sooft1k/Drohne/hardware/fc/docs/fc_3d_oben.png

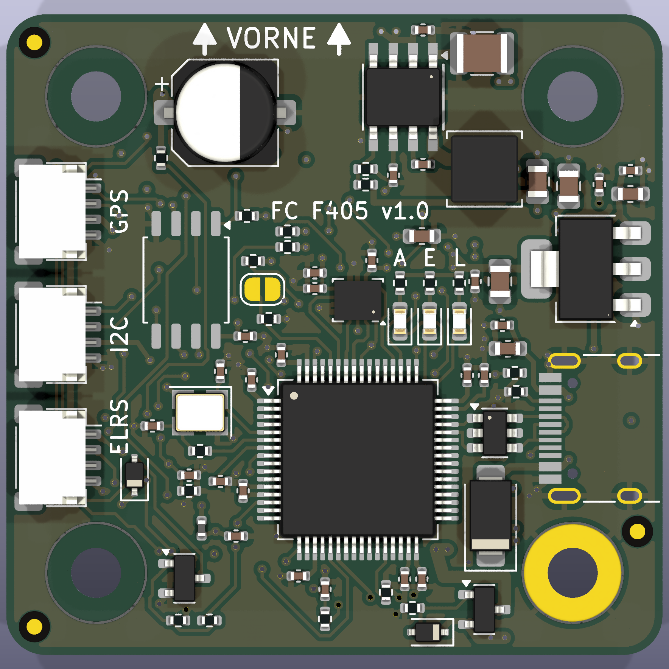
hardware/fc/docs/fc_3d_oben.png
