sooft1k/Drohne/hardware/fc/docs/fc_3d_unten.png

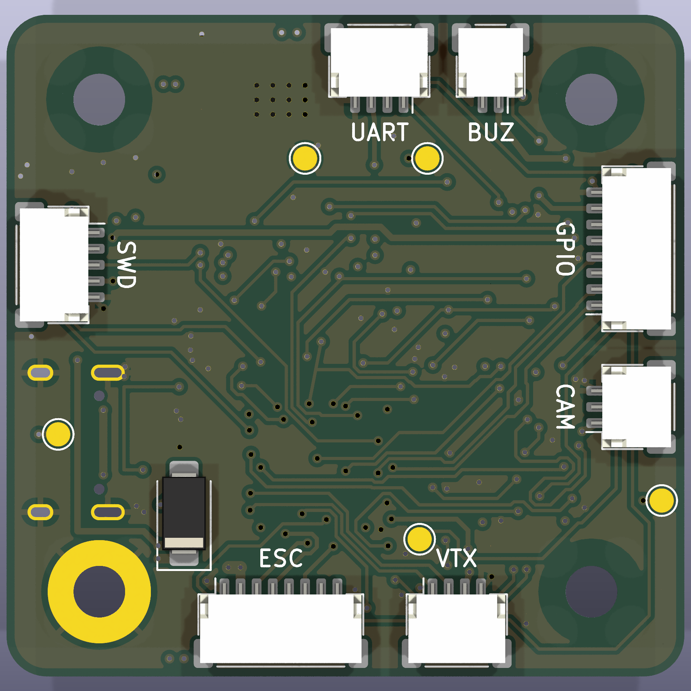
hardware/fc/docs/fc_3d_unten.png
