sooft1k/Drohne/hardware/fc/docs/fc_bot.png

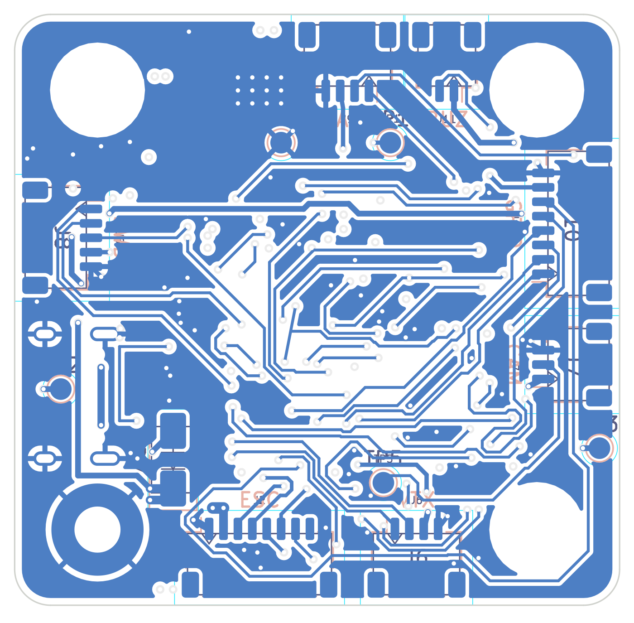
hardware/fc/docs/fc_bot.png
