sooft1k/Drohne/hardware/fc/docs/fc_in1.png

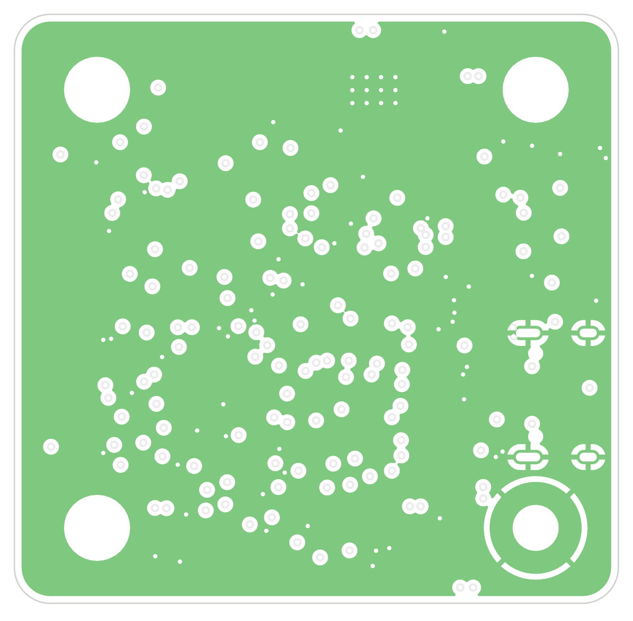
hardware/fc/docs/fc_in1.png
