sooft1k/Drohne/hardware/fc/docs/fc_in2.png

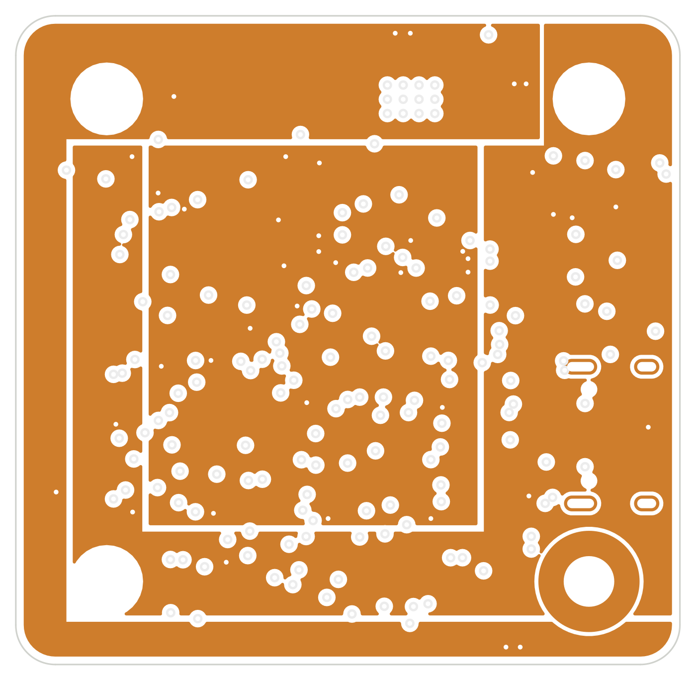
hardware/fc/docs/fc_in2.png
