sooft1k/Drohne/Pinlayout.jpeg

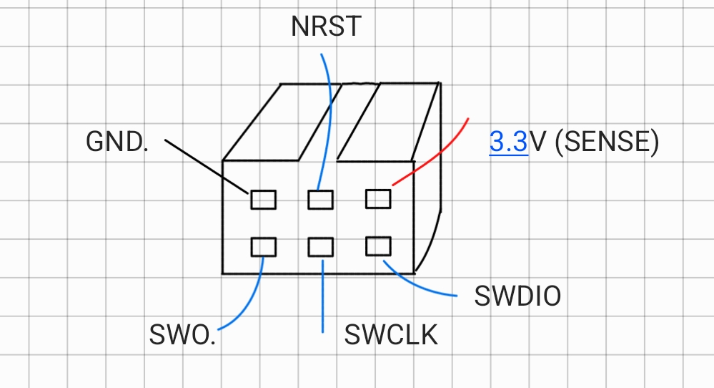
Pinlayout.jpeg
