sooft1k/Drohne/hardware/fc/fertigung/jlcpcb_bom.csv

Comment | Designator | Footprint | LCSC Part #
100 nF 50 V X7R 0402 | C1,C2,C3,C4,C5,C7,C11,C14,C15,C16,C18,C20,C23,C24,C28,C30,C32,C34 | C_0402_1005Metric | C307331
10 uF 25 V X5R 0603 | C6,C29,C33 | C_0603_1608Metric | C96446
1 uF 25 V X5R 0402 | C8,C25 | C_0402_1005Metric | C52923
2,2 uF 6,3 V X5R 0402 | C9,C10,C17 | C_0402_1005Metric | C12530
18 pF 50 V C0G 0402 | C12,C13 | C_0402_1005Metric | C1549
47 uF 35 V Elko 6,3x5,4, 850 mOhm @100 kHz, 140 mA @120 Hz | C21 | CP_Elec_6.3x5.4 | C48970990
10 uF 50 V X7R 1210 | C22 | C_1210_3225Metric | C17498688
22 uF 25 V X5R 0805 | C26,C27,C31 | C_0805_2012Metric | C45783
Zener 15 V SOD-323 | D1 | D_SOD-323 | C19077448
Schottky 40 V 1 A SMA | D2,D7 | D_SMA | C2480
LED rot 0603 | D3 | LED_0603_1608Metric | C2286
LED gelb 0603 (AlGaInP) | D4 | LED_0603_1608Metric | C72038
LED gruen 0603 (InGaN, Uf ca. 2,7 V) | D5 | LED_0603_1608Metric | C72043
Schaltdiode SOD-323 | D6 | D_SOD-323 | C2128
Ferrit 600 Ohm@100 MHz 0402, 0,23 Ohm | FB1 | L_0402_1005Metric | C7509833
USB-C-Buchse 16 Pin | J1 | USB_C_Receptacle_HRO_TYPE-C-31-M-12_Kante | C165948
JST-SH-Buchse 8-polig seitlich SMD | J2,J10 | JST_SH_SM08B-SRSS-TB_1x08-1MP_P1.00mm_Horizontal | C7430450
JST-SH-Buchse 4-polig seitlich SMD | J3,J4,J5,J6,J9 | JST_SH_SM04B-SRSS-TB_1x04-1MP_P1.00mm_Horizontal | C7430446
JST-SH-Buchse 3-polig seitlich SMD | J7 | JST_SH_SM03B-SRSS-TB_1x03-1MP_P1.00mm_Horizontal | C7430445
JST-SH-Buchse 5-polig seitlich SMD | J8 | JST_SH_SM05B-SRSS-TB_1x05-1MP_P1.00mm_Horizontal | C7430447
JST-SH-Buchse 2-polig seitlich SMD | J11 | JST_SH_SM02B-SRSS-TB_1x02-1MP_P1.00mm_Horizontal | C7430444
3,3 uH 34 mOhm 4,8/6,6 A, XAL/XGL-40xx-Landemuster | L1 | L_Coilcraft_XAL4040-XXX | C6937839
P-MOSFET -40 V SOT-23 | Q1 | SOT-23 | C146287
N-MOSFET 30 V 5,7 A SOT-23, V_GS(th) max. 1,45 V | Q2 | SOT-23 | C20917
10 kOhm 1 % 0402 | R1,R2,R5,R7,R8,R18 | R_0402_1005Metric | C25744
0 Ohm 0402 | R3 | R_0402_1005Metric | C17168
100 kOhm 1 % 0402 | R4,R9 | R_0402_1005Metric | C25741
1 kOhm 1 % 0402 | R6,R14,R15,R17 | R_0402_1005Metric | C11702
33 kOhm 1 % 0402 | R10 | R_0402_1005Metric | C25779
8,2 kOhm 1 % 0402 | R11 | R_0402_1005Metric | C25924
5,1 kOhm 1 % 0402 | R12,R13,R19,R20 | R_0402_1005Metric | C25905
470 Ohm 1 % 0402 | R16 | R_0402_1005Metric | C25117
Mikrocontroller LQFP-64 | U1 | LQFP-64_10x10mm_P0.5mm | C15742
IMU LGA-14 | U2 | LGA-14_3x2.5mm_P0.5mm_LayoutBorder3x4y | C1850418
SPI-Flash 128 Mbit SOIC-8 208 mil | U3 | SOIC-8_5.23x5.23mm_P1.27mm | C97521
Schaltregler 3 A HSOP-8 | U4 | Texas_HSOP-8-1EP_3.9x4.9mm_P1.27mm_ThermalVias_TopOnly | C544370
LDO 3,3 V SOT-223 | U5 | SOT-223-3_TabPin2 | C6186
USB-ESD-Schutz SOT-23-6 | U6 | SOT-23-6 | C7519
Quarz 8 MHz 12 pF +-10 ppm 3225-4P | Y1 | Crystal_SMD_3225-4Pin_3.2x2.5mm | C20617566
