sooft1k/Drohne/Frame/frame_assembly.step

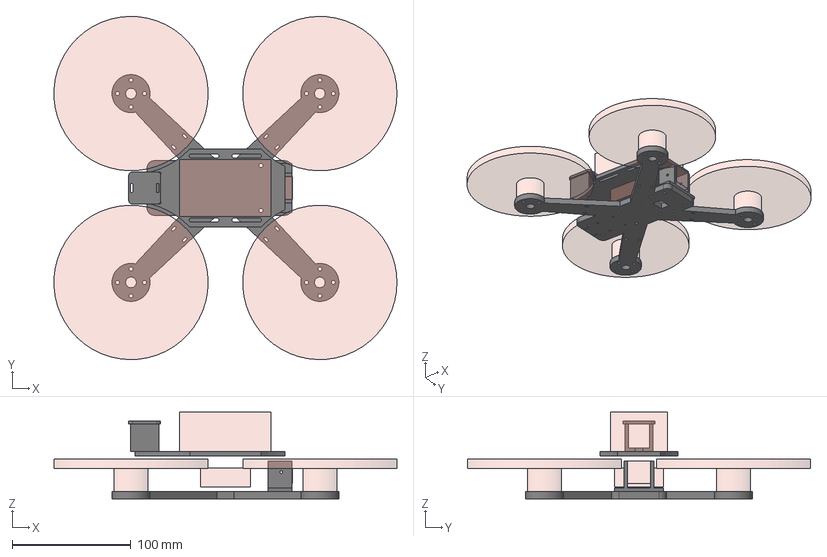
[picture p7: CAD file, 2026-11-09]
Frame/frame_assembly.step
289.0 x 289.0 x 73.0 mm
bottom_plate
top_plate
camera_mount
gps_mount
motors
props
stack
battery
camera
