sooft1k/Drohne/Frame/camera_mount.stl

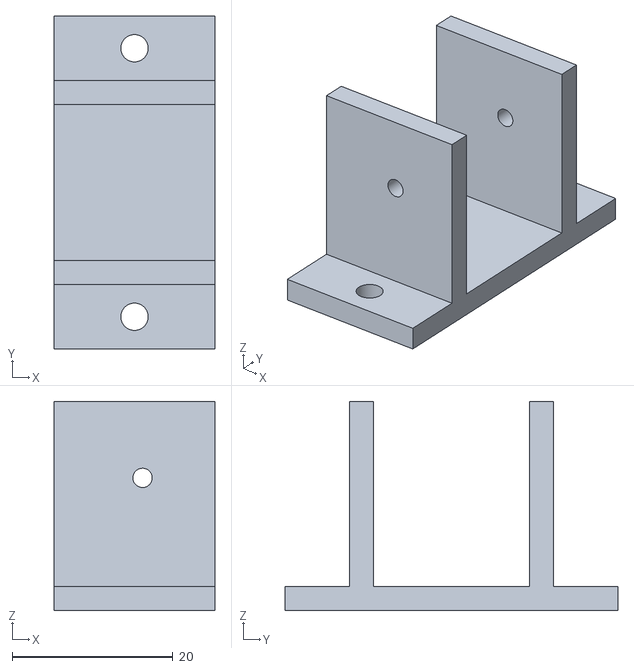
[picture p8: CAD file, 2026-11-09]
Frame/camera_mount.stl
20.0 x 41.4 x 26.0
