sooft1k/Drohne/Frame/top_plate.stl

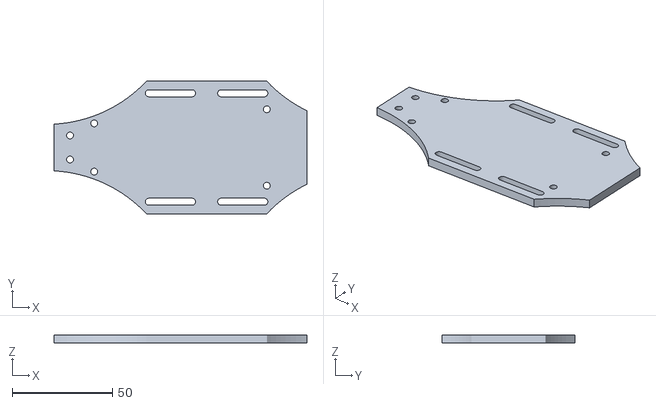
[picture p9: CAD file, 2026-11-09]
Frame/top_plate.stl
126.0 x 66.0 x 4.00
