sooft1k/Drohne/Frame/bottom_plate.stl

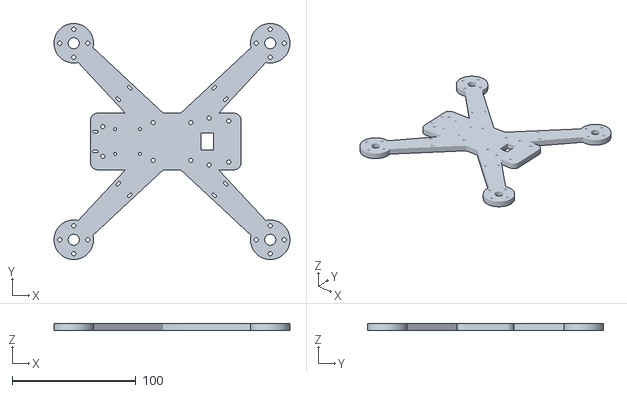
[picture p10: CAD file, 2026-11-09]
Frame/bottom_plate.stl
191.1 x 191.1 x 6.00
