sooft1k/Drohne/hardware/fc/fc.kicad_pcb

## KiCad design hardware/fc/fc.kicad_pcb (2026-10-15)

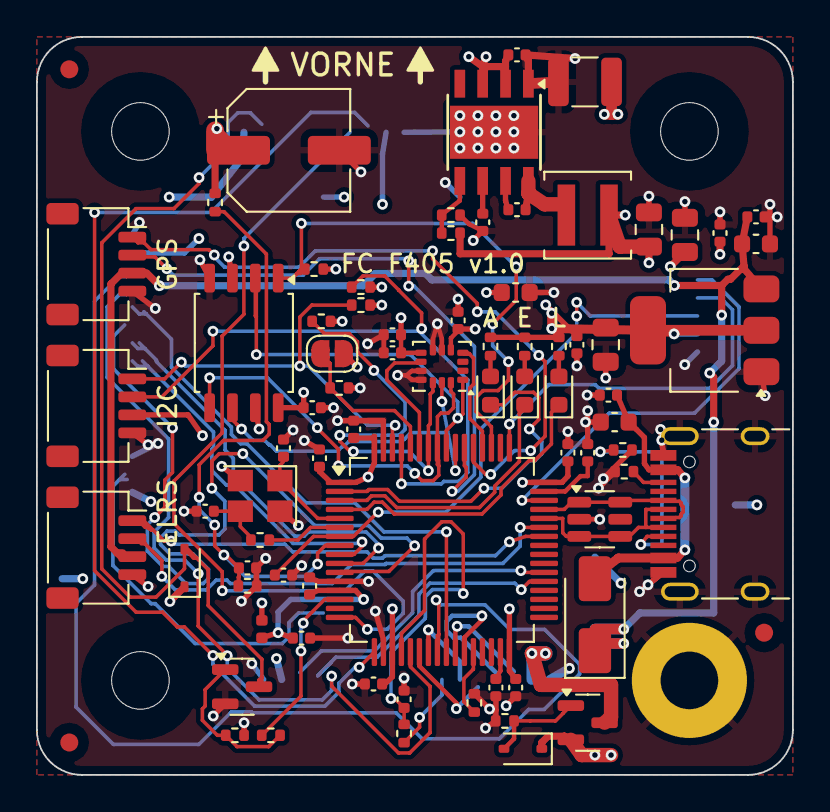
[picture p11: board fc.kicad_pcb from above]

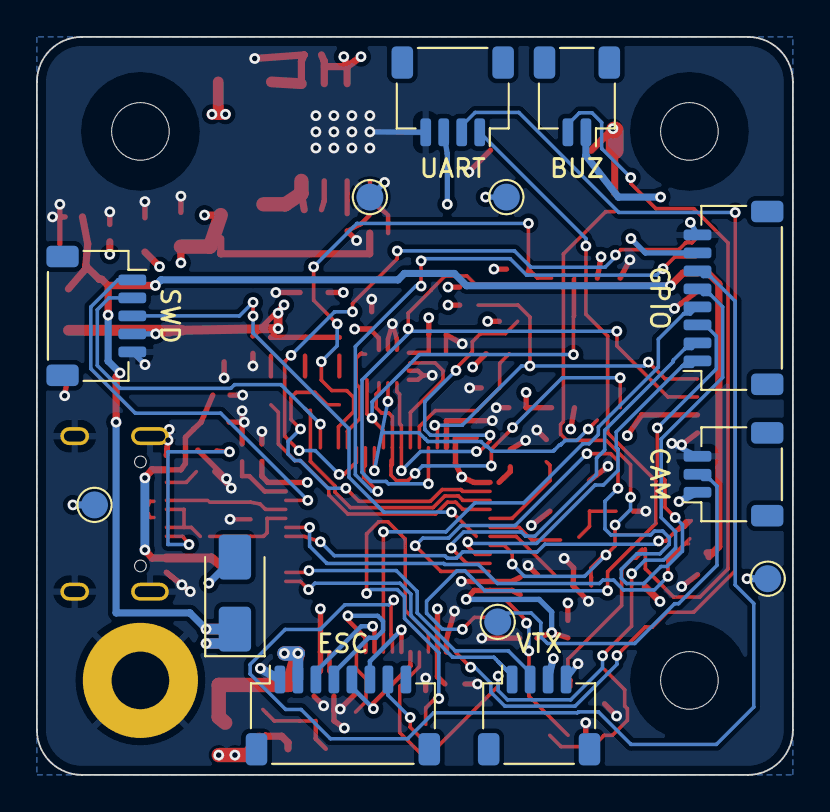
[picture p12: board fc.kicad_pcb from below]

Board: 4 copper layers, 42.0 x 41.0 mm, 95 parts (13 on the bottom side), 67 nets.

Parts:
C1, C2, C3, C4, C5, C7, C11, C14, C15, C16, C18, C20, C24, C28, C30, C32, C34: 100nF; C_0402_1005Metric
C6, C29, C33: 10uF/25V; C_0603_1608Metric
C8, C25: 1uF; C_0402_1005Metric
C9, C10, C17: 2.2uF; C_0402_1005Metric
C12, C13: 18pF; C_0402_1005Metric
C21: 47uF/35V; CP_Elec_6.3x5.4
C22: 10uF/50V; C_1210_3225Metric
C23: 100nF/50V; C_0402_1005Metric
C26, C27: 22uF/16V; C_0805_2012Metric
C31: 22uF; C_0805_2012Metric
D1: BZT52C15S; D_SOD-323
D2, D7: SS14; D_SMA
D3: rot; LED_0603_1608Metric
D4: gelb; LED_0603_1608Metric
D5: gruen; LED_0603_1608Metric
D6: 1N4148WS; D_SOD-323
FB1: 600R@100MHz; L_0402_1005Metric
FID1, FID2, FID3: Fiducial; Fiducial_1mm_Mask2mm
H1, H3, H4: M3; MountingHole_3.2mm_M3
H2: M3 GND; MountingHole_3.2mm_M3_Pad
J1: USB-C; USB_C_Receptacle_HRO_TYPE-C-31-M-12_Kante
J2: ESC; JST_SH_SM08B-SRSS-TB_1x08-1MP_P1.00mm_Horizontal
J3: ELRS; JST_SH_SM04B-SRSS-TB_1x04-1MP_P1.00mm_Horizontal
J4: I2C; JST_SH_SM04B-SRSS-TB_1x04-1MP_P1.00mm_Horizontal
J5: GPS; JST_SH_SM04B-SRSS-TB_1x04-1MP_P1.00mm_Horizontal
J6: VTX; JST_SH_SM04B-SRSS-TB_1x04-1MP_P1.00mm_Horizontal
J7: CAM; JST_SH_SM03B-SRSS-TB_1x03-1MP_P1.00mm_Horizontal
J8: SWD; JST_SH_SM05B-SRSS-TB_1x05-1MP_P1.00mm_Horizontal
J9: UART; JST_SH_SM04B-SRSS-TB_1x04-1MP_P1.00mm_Horizontal
J10: GPIO; JST_SH_SM08B-SRSS-TB_1x08-1MP_P1.00mm_Horizontal
J11: BUZZER; JST_SH_SM02B-SRSS-TB_1x02-1MP_P1.00mm_Horizontal
JP1: BOOT0; SolderJumper-2_P1.3mm_Open_RoundedPad1.0x1.5mm
L1: 3.3uH; L_Coilcraft_XAL4040-XXX
Q1: Si2319CDS; SOT-23
Q2: AO3400A; SOT-23
R1, R2, R5, R7, R8, R18: 10k; R_0402_1005Metric
R3: 0R; R_0402_1005Metric
R4, R9: 100k; R_0402_1005Metric
R6, R14, R15, R17: 1k; R_0402_1005Metric
R10: 33k; R_0402_1005Metric
R11: 8.2k; R_0402_1005Metric
R12, R13, R19, R20: 5.1k; R_0402_1005Metric
R16: 470R; R_0402_1005Metric
TP1: 3V3; TestPoint_Pad_D1.5mm
TP2: 5V; TestPoint_Pad_D1.5mm
TP3: VBAT; TestPoint_Pad_D1.5mm
TP4: GND; TestPoint_Pad_D1.5mm
TP5: VIDEO; TestPoint_Pad_D1.5mm
U1: STM32F405RGT6; LQFP-64_10x10mm_P0.5mm
U2: ICM-42688-P; LGA-14_3x2.5mm_P0.5mm_LayoutBorder3x4y
U3: W25Q128JVSIQ; SOIC-8_5.23x5.23mm_P1.27mm
U4: LMR33630BDDA; Texas_HSOP-8-1EP_3.9x4.9mm_P1.27mm_ThermalVias_TopOnly
U5: AMS1117-3.3; SOT-223-3_TabPin2
U6: USBLC6-2SC6; SOT-23-6
Y1: 8MHz; Crystal_SMD_3225-4Pin_3.2x2.5mm

Connections:
+3V3: C1.1, C2.1, C3.1, C4.1, C5.1, C6.1, C16.1, C17.1, C18.1, C20.1, C31.1, C32.1, FB1.1, J4.3, J8.4, J9.3, J10.7, JP1.2, R7.2, R8.2, R14.1, R15.1, R16.1, R19.2, R20.2, TP1.1, U1.1, U1.19, U1.32, U1.48, U1.64, U2.5, U2.8, U3.3, U3.7, U3.8, U5.2
+3V3A: C7.1, C8.1, FB1.2, U1.13
+4V5: C29.1, C30.1, D2.1, D7.1, J3.3, J5.3, U5.3
+5V: C26.1, C27.1, C28.1, D6.1, D7.2, J6.3, J7.1, J11.1, L1.2, R10.1, TP2.1
BOOT0: JP1.1, R1.1, U1.60
BOOT1: R2.1, U1.28
BUCK_BOOT: C24.1, U4.7
BUCK_FB: R10.2, R11.1, U4.5
BUCK_SW: C24.2, L1.1, U4.8
BUCK_VCC: C25.1, U4.6
BUZZER: R17.1, U1.14
BUZ_G: Q2.1, R17.2, R18.1
BUZ_N: D6.2, J11.2, Q2.3
CAM_VIDEO: J7.2, TP5.1
CURR_IN: J2.7, R6.1
CURR_SENSE: C15.1, R6.2, U1.20
DBG_RX: J9.2, U1.17
DBG_TX: J9.1, U1.16
ELRS_RX: J3.2, U1.43
ELRS_TX: J3.1, U1.42
FLASH_CS: R8.1, U1.51, U3.1
GND: C1.2, C2.2, C3.2, C4.2, C5.2, C6.2, C7.2, C8.2, C9.2, C10.2, C11.2, C12.2, C13.2, C14.2, C15.2, C16.2, C17.2, C18.2, C20.2, C21.2, C22.2, C23.2, C25.2, C26.2, C27.2, C28.2, C29.2, C30.2, C31.2, C32.2, C33.2, C34.2, H2.1, J1.A1, J1.A12, J1.B1, J1.B12, J1.S1, J2.1, J3.4, J4.4, J5.4, J6.4, J7.3, J8.5, J9.4, J10.8, Q2.2, R1.2, R2.2, R5.2, R9.2, R11.2, R12.2, R13.2, R18.2, TP4.1, U1.12, U1.18, U1.63, U2.6, U2.7, U2.10, U2.11, U3.4, U4.1, U4.9, U5.1, U6.2, Y1.2, Y1.4
GPIO1: J10.1, U1.9
GPIO2: J10.2, U1.10
GPIO3: J10.3, U1.11
GPIO4: J10.4, U1.25
GPIO5: J10.5, U1.21
GPIO6: J10.6, U1.24
GPS_RX: J5.2, U1.54
GPS_TX: J5.1, U1.53
GYRO_CS: R7.1, U1.58, U2.12
GYRO_INT1: U1.52, U2.4
GYRO_INT2: U1.59, U2.9
I2C_SCL: J4.2, R20.1, U1.61
I2C_SDA: J4.1, R19.1, U1.62
LED_ARM: D3.1, U1.2
LED_ARM_A: D3.2, R14.2
LED_ERR: D4.1, U1.3
LED_ERR_A: D4.2, R15.2
LED_LINK: D5.1, U1.4
LED_LINK_A: D5.2, R16.2
M1: J2.3, U1.26
M2: J2.4, U1.27
M3: J2.5, U1.22
M4: J2.6, U1.23
NRST: C11.1, J8.3, U1.7
OSC_IN: C12.1, U1.5, Y1.1
OSC_OUT: R3.1, U1.6
Q1_G: D1.2, Q1.1, R9.1
SPI1_MISO: U1.56, U2.1, U3.2
SPI1_MOSI: U1.57, U2.14, U3.5
SPI1_SCK: U1.55, U2.13, U3.6
SWCLK: J8.2, U1.49
SWDIO: J8.1, U1.46
USB_CC1: J1.A5, R12.1
USB_CC2: J1.B5, R13.1
USB_DM: J1.A7, J1.B7, U1.44, U6.3, U6.4
USB_DP: J1.A6, J1.B6, U1.45, U6.1, U6.6
VBAT: C21.1, C22.1, C23.1, D1.1, Q1.2, R4.1, TP3.1, U4.2, U4.3
VBAT_IN: J2.2, Q1.3
VBAT_SENSE: C14.1, R4.2, R5.1, U1.8
VBUS: C33.1, C34.1, D2.2, J1.A4, J1.A9, J1.B4, J1.B9
VCAP1: C9.1, U1.31
VCAP2: C10.1, U1.47
VTX_RX: J6.2, U1.38
VTX_TX: J6.1, U1.37
XTAL_OUT: C13.1, R3.2, Y1.3
