sooft1k/Drohne/Sensors/command.c

#include "command.h"
#include "motor.h"
#include "control.h"
#include "mixer.h"
#include "mpu6050.h"
#include "battery.h"
#include "crsf.h"
#include "rc.h"
#include "arming.h"
#include <stdio.h>
#include <string.h>
#include <stdlib.h>

#define CMD_BUF_SIZE 32

/* aus main.c */
extern uint32_t loop_hz;
extern volatile uint32_t loop_missed;
extern uint8_t mpu_ok;

static UART_HandleTypeDef *cmd_uart = 0;
static uint8_t rx_char;
static char line[CMD_BUF_SIZE];
static uint8_t line_len = 0;
static volatile uint8_t line_ready = 0;
static volatile uint8_t stream_on = 0;
static volatile uint8_t kipp_on = 0;

/* Terminal-arm braucht eine Bestaetigung mit 'ja' innerhalb dieser Zeit */
#define ARM_CONFIRM_MS 5000
static uint8_t arm_confirm = 0;     /* 1 = 'arm' gesendet, wartet auf 'ja' */
static uint32_t arm_confirm_ms = 0; /* Zeitpunkt des 'arm' */

/* Abschaltung fuer den Terminal-Arm */
static volatile uint32_t last_rx_ms = 0; /* letztes fehlerfreies Zeichen, HAL_GetTick() */
static uint8_t term_armed = 0;           /* 1 = ueber das Terminal gearmt */
static uint32_t term_arm_count = 0;      /* Arming_ArmCount() beim Terminal-Arm */
static uint8_t keepalive_report = 0;     /* Abschaltung noch nicht gemeldet */

void Command_Init(UART_HandleTypeDef *huart)
{
    cmd_uart = huart;
    line_len = 0;
    line_ready = 0;
    HAL_UART_Receive_IT(cmd_uart, &rx_char, 1);
}

uint8_t Command_StreamOn(void)
{
    return stream_on;
}

uint8_t Command_KippOn(void)
{
    return kipp_on;
}

void Command_RxByte(void)
{
    char c = (char)rx_char;

    /* Nur fehlerfreie Zeichen halten den Terminal-Arm am Leben. Bei Rahmen-,
     * Rausch- oder Ueberlauffehlern setzt die HAL ErrorCode, bevor sie das
     * Zeichen zustellt - z.B. Stoerungen auf einer offenen Leitung. */
    if (cmd_uart->ErrorCode == HAL_UART_ERROR_NONE)
        last_rx_ms = HAL_GetTick();

    if (c == '\r' || c == '\n')
    {
        if (line_len > 0)
        {
            line[line_len] = '\0';
            line_ready = 1;
        }
    }
    else if (line_len < (CMD_BUF_SIZE - 1))
    {
        line[line_len++] = c;
    }

    HAL_UART_Receive_IT(cmd_uart, &rx_char, 1);
}

/* Bei Ueberlauf (ORE) beendet die HAL den Empfang - neu starten, sonst nimmt
 * das Terminal keine Befehle mehr an (auch kein disarm). Bei Rahmen- oder
 * Rauschfehlern laeuft der Empfang weiter, das kaputte Zeichen ist aber
 * schon in der Zeile - die angefangene Zeile verwerfen. */
void Command_RxError(void)
{
    if (!cmd_uart)
        return;
    if (!line_ready)
        line_len = 0;
    __HAL_UART_CLEAR_OREFLAG(cmd_uart);
    __HAL_UART_CLEAR_NEFLAG(cmd_uart);
    __HAL_UART_CLEAR_FEFLAG(cmd_uart);
    HAL_UART_Receive_IT(cmd_uart, &rx_char, 1);
}

void Command_ArmWatchdog(void)
{
    /* Disarmt, oder seitdem anders neu gearmt (Arm-Schalter): dann gilt
     * die Abschaltung nicht mehr - beim Funk wacht der Failsafe. */
    if (!Motor_IsArmed() || Arming_ArmCount() != term_arm_count)
        term_armed = 0;
    if (!term_armed)
        return;

    /* Zeitstempel zuerst lesen, dann die Zeit (wie CRSF_AgeMs): kommt genau
     * dazwischen ein Zeichen, wird die Differenz sonst negativ = riesig. */
    const uint32_t last = last_rx_ms;
    if (HAL_GetTick() - last > COMMAND_KEEPALIVE_MS)
    {
        Arming_Disarm();
        term_armed = 0;
        keepalive_report = 1;
    }
}

void Command_Process(void)
{
    if (keepalive_report && !Motor_IsArmed())
    {
        keepalive_report = 0;
        printf(">> DISARMED - laenger als %d ms kein Zeichen vom Terminal.\r\n",
               COMMAND_KEEPALIVE_MS);
    }

    if (!line_ready)
        return;

    /* Gearmt sind die Terminal-Ausgaben aus (siehe _write in main.c).
     * Dann wirken nur disarm/stop, t und curcal (braucht Strom, also laufende
     * Motoren) - Abstimmen, Filter und Anzeigen gehen nur disarmed. */
    if (Motor_IsArmed() &&
        !(strcmp(line, "disarm") == 0 || strcmp(line, "stop") == 0 ||
          (line[0] == 't' && line[1] == ' ') || strncmp(line, "curcal ", 7) == 0))
    {
        line_len = 0;
        line_ready = 0;
        return;
    }

    /* ---------- Motorsteuerung ----------
     * 'arm' geht nur ohne Funk (mit Funk entscheidet der Arm-Schalter).
     * Es prueft wie der Arm-Schalter Sensor, Neigung und Akku und will
     * dann eine Bestaetigung mit 'ja'. Die Motoren laufen danach sofort im
     * Leerlauf. */
    if ((strcmp(line, "arm") == 0 || strcmp(line, "ja") == 0) && CRSF_LinkUp())
    {
        /* Ein Terminal-arm wuerde im naechsten Zyklus ohnehin aufgehoben */
        arm_confirm = 0;
        printf(">> Funk ist verbunden - bitte mit dem Arm-Schalter armen.\r\n");
    }
    else if (strcmp(line, "arm") == 0)
    {
        ArmCheck_t r = Arming_Check();
        if (r != ARM_OK)
        {
            arm_confirm = 0;
            printf(">> Arming abgelehnt: %s\r\n", Arming_Text(r));
        }
        else
        {
            arm_confirm = 1;
            arm_confirm_ms = HAL_GetTick();
            printf(">> Propeller ab? Motoren laufen danach sofort im Leerlauf.\r\n");
            printf(">> Bestaetigen mit 'ja' innerhalb von %d s.\r\n", ARM_CONFIRM_MS / 1000);
        }
    }
    else if (strcmp(line, "ja") == 0)
    {
        if (!arm_confirm || HAL_GetTick() - arm_confirm_ms > ARM_CONFIRM_MS)
        {
            arm_confirm = 0;
            printf(">> Nichts zu bestaetigen - erst 'arm' senden.\r\n");
        }
        else
        {
            arm_confirm = 0;
            /* nochmal pruefen, seit dem 'arm' koennen 5 s vergangen sein.
             * Die Meldung kommt vor dem Armen - danach ist das Terminal stumm. */
            ArmCheck_t r = Arming_Check();
            if (r == ARM_OK)
            {
                printf(">> ARMED - Terminal-Ausgaben aus bis 'disarm'.\r\n");
                printf(">> Mindestens jede Sekunde ein Zeichen senden (z.B. Enter alle 0,5 s),\r\n");
                printf(">> sonst gehen die Motoren aus.\r\n");
                last_rx_ms = HAL_GetTick();
                term_armed = (Arming_Arm() == ARM_OK) ? 1 : 0;
                term_arm_count = Arming_ArmCount();
            }
            else
            {
                printf(">> Arming abgelehnt: %s\r\n", Arming_Text(r));
            }
        }
    }
    else if (strcmp(line, "disarm") == 0 || strcmp(line, "stop") == 0)
    {
        arm_confirm = 0;
        Arming_Disarm(); /* sperrt auch das Armen ueber den noch oben stehenden Schalter */
        printf(">> DISARMED - alle Motoren gestoppt.\r\n");
    }

    /* ---------- Status ---------- */
    else if (strcmp(line, "status") == 0)
    {
        printf(">> Status: %s | Modus: %s | Gas: %.0f%% | Funk: %s\r\n",
               Motor_IsArmed() ? "ARMED" : "DISARMED",
               (flight_mode == MODE_ANGLE) ? "ANGLE" : "RATE",
               setpoint.throttle,
               CRSF_LinkUp() ? "OK" : "KEIN SIGNAL");
        printf("   Stream: %s | Loop: %lu Hz | Motoren: %lu Hz\r\n",
               stream_on ? "AN" : "AUS", loop_hz, Motor_UpdateRateHz());
        printf("   Sensor: %s | Lesefehler bisher: %lu | Arming: %s\r\n",
               !mpu_ok ? "FEHLT" : (MPU6050_Failed() ? "AUSGEFALLEN" : (MPU6050_Healthy() ? "OK" : "nicht bereit")),
               MPU6050_ErrorCount(), Arming_Text(Arming_Check()));
        if (Arming_BatBypass())
            printf("   %s\r\n", ARM_BAT_BYPASS_WARNUNG);
    }
    else if (strcmp(line, "loop") == 0)
    {
        printf(">> Regeltakt: %lu Hz | verpasste Zyklen: %lu\r\n",
               loop_hz, loop_missed);
    }

    /* ---------- Funkempfang ---------- */
    else if (strcmp(line, "rc") == 0)
    {
        RC_PrintStatus();
    }

    /* ---------- Akku ---------- */
    else if (strcmp(line, "bat") == 0)
    {
        if (Battery_Cells() == 0)
        {
            printf(">> Akku: kein Akku erkannt (%.2f V am Teiler)\r\n", Battery_Volt());
        }
        else
        {
            printf(">> Akku: %.2f V | %uS | %.2f V pro Zelle | %s\r\n",
                   Battery_Volt(), Battery_Cells(),
                   Battery_CellVolt(), Battery_StateText());
        }
        printf("   Strom: %.2f A | verbraucht: %.0f mAh | Gasgrenze: %.0f %%\r\n",
               Battery_Current(), Battery_MahUsed(), Battery_ThrottleCap());
        printf("   Stromsensor: %.2f mV/A, Nullpunkt %.1f mV\r\n",
               Battery_CurrentMvPerA(), Battery_CurrentZeroMv());
        if (Arming_BatBypass())
            printf("   %s (Gasbegrenzung aus)\r\n", ARM_BAT_BYPASS_WARNUNG);
    }
    else if (strncmp(line, "batcal ", 7) == 0)
    {
        float v = strtof(line + 7, 0);
        if (Battery_Calibrate(v))
            printf(">> Kalibriert auf %.2f V (Faktor %.4f)\r\n", Battery_Volt(), Battery_GetScale());
        else
            printf(">> Abgelehnt: Akku nicht erkannt oder mehr als 20 %% Abweichung\r\n");
    }

    /* ---------- Pruefstand ohne Akkuteiler ----------
     * batbypass: Akkupruefung beim Armen und Gasbegrenzung aus, nur bis
     * zum naechsten Reset. Gearmt kommt der Befehl gar nicht hier an. */
    else if (strcmp(line, "batbypass") == 0)
    {
        Arming_SetBatBypass(1);
        printf(">> %s\r\n", ARM_BAT_BYPASS_WARNUNG);
        printf(">> Gilt bis zum Reset oder 'batbypass off'. Alle anderen Pruefungen bleiben.\r\n");
    }
    else if (strcmp(line, "batbypass off") == 0)
    {
        Arming_SetBatBypass(0);
        printf(">> Akkupruefung wieder AN\r\n");
    }

    /* ---------- Strommessung kalibrieren ----------
     * curzero: Motoren aus, aktueller Wert = 0 A.
     * curcal 5.2: mit einem bekannten Strom (Zangen- oder Leistungsmesser
     * in der Akkuleitung) die Skalierung bestimmen. */
    else if (strcmp(line, "curzero") == 0)
    {
        if (Battery_CurrentZero())
            printf(">> Strom-Nullpunkt: %.1f mV\r\n", Battery_CurrentZeroMv());
        else
            printf(">> Nur disarmed\r\n");
    }
    else if (strncmp(line, "curcal ", 7) == 0)
    {
        float a = strtof(line + 7, 0);
        if (Battery_CurrentCalibrate(a))
            printf(">> Stromsensor: %.2f mV/A\r\n", Battery_CurrentMvPerA());
        else
            printf(">> Abgelehnt: mindestens 1 A und ein deutliches Signal noetig\r\n");
    }

    /* ---------- Filter ----------
     * Muss VOR dem PID-Block stehen, sonst wird 'alpf' als Angle-Befehl gelesen. */
    else if (strcmp(line, "filt") == 0)
    {
        printf(">> Gyro-Tiefpass : %.0f Hz\r\n", MPU6050_GetGyroLPF());
        printf(">> Accel-Tiefpass: %.0f Hz\r\n", MPU6050_GetAccelLPF());
        printf(">> Komplementaer : tau %.2f s\r\n", MPU6050_GetCompTau());
    }
    else if (strncmp(line, "glpf ", 5) == 0)
    {
        float v = strtof(line + 5, 0);
        MPU6050_SetGyroLPF(v);
        printf(">> Gyro-Tiefpass: %.0f Hz%s\r\n", MPU6050_GetGyroLPF(),
               (v <= 0.0f) ? " (aus)" : "");
    }
    else if (strncmp(line, "alpf ", 5) == 0)
    {
        float v = strtof(line + 5, 0);
        MPU6050_SetAccelLPF(v);
        printf(">> Accel-Tiefpass: %.0f Hz\r\n", MPU6050_GetAccelLPF());
    }
    else if (strncmp(line, "tau ", 4) == 0)
    {
        float v = strtof(line + 4, 0);
        MPU6050_SetCompTau(v);
        printf(">> Komplementaerfilter tau: %.2f s\r\n", MPU6050_GetCompTau());
    }

    /* ---------- Flugmodus ---------- */
    else if (strcmp(line, "angle") == 0)
    {
        Control_SetMode(MODE_ANGLE);
        printf(">> Modus: ANGLE (richtet sich selbst auf)\r\n");
    }
    else if (strcmp(line, "rate") == 0)
    {
        Control_SetMode(MODE_RATE);
        printf(">> Modus: RATE (Acro)\r\n");
    }

    /* ---------- PID ---------- */
    else if (strcmp(line, "pid") == 0)
    {
        Control_PrintGains();
    }

    /* ---------- Stream ---------- */
    else if (strcmp(line, "stream on") == 0)
    {
        stream_on = 1;
        kipp_on = 0;
        printf(">> Stream AN (50 Hz Ausgabe)\r\n");
    }
    else if (strcmp(line, "stream off") == 0)
    {
        stream_on = 0;
        printf(">> Stream AUS\r\n");
    }

    /* ---------- Kipptest ohne Propeller ----------
     * Zeigt 5x pro Sekunde, was der Mixer bei 50 % Gas aus der aktuellen
     * Lage machen wuerde. Nur disarmed, die Motoren bleiben aus. */
    else if (strcmp(line, "kipp") == 0 && Motor_IsArmed())
    {
        printf(">> Kipptest nur disarmed - erst 'disarm'.\r\n");
    }
    else if (strcmp(line, "kipp") == 0)
    {
        kipp_on = !kipp_on;
        if (kipp_on)
        {
            stream_on = 0;
            printf(">> Kipptest AN (Vorschau bei 50 %% Gas, Motoren bleiben aus).\r\n");
            printf(">> Nochmal 'kipp' zum Beenden.\r\n");
        }
        else
        {
            printf(">> Kipptest AUS\r\n");
        }
    }

    /* ---------- PID-Werte setzen: rrp 1.2 / arp 4.0 ----------
     * Zeichen 1: r = Rate (innen), a = Angle (aussen)
     * Zeichen 2: r/p/y = Achse
     * Zeichen 3: p/i/d = Term */
    else if ((line[0] == 'r' || line[0] == 'a') &&
             (line[1] == 'r' || line[1] == 'p' || line[1] == 'y') &&
             (line[2] == 'p' || line[2] == 'i' || line[2] == 'd'))
    {
        char *end;
        float v = strtof(line + 3, &end);

        if (end != line + 3)
        {
            if (Control_SetGain(line[0], line[1], line[2], v))
                printf(">> %c%c%c = %.4f\r\n", line[0], line[1], line[2], v);
            else
                printf(">> Ungueltig (Yaw hat keinen Winkelregler, Wert 0..1000)\r\n");
        }
        else
        {
            printf(">> Format: rrp 1.2  (r/a Kreis, r/p/y Achse, p/i/d Term)\r\n");
        }
    }

    /* ---------- Gas setzen: t 20 ----------
     * Nur zum Testen ohne Funke und nur gearmt - disarmed gesetztes Gas
     * wuerde sonst beim Armen sofort anliegen. Sobald die Funke verbunden
     * ist, ueberschreibt RC_Update den Wert im naechsten Zyklus. */
    else if (line[0] == 't' && line[1] == ' ')
    {
        char *end;
        float v = strtof(line + 2, &end);

        if (!Motor_IsArmed())
        {
            printf(">> Gesperrt: Gas nur gearmt ('arm', dann 'ja').\r\n");
        }
        else if (end != line + 2)
        {
            if (!(v >= 0.0f)) /* auch NaN */
                v = 0.0f;
            if (v > 100.0f)
                v = 100.0f;
            setpoint.throttle = v;
            printf(">> Gas: %.0f%%\r\n", v);
            if (CRSF_LinkUp())
                printf(">> Achtung: Funk ist verbunden, der Knueppel ueberschreibt das sofort.\r\n");
        }
        else
        {
            printf(">> Format: t 20\r\n");
        }
    }

    /* ---------- Mixer-Ausgaben anzeigen ---------- */
    else if (strcmp(line, "mix") == 0)
    {
        float m1, m2, m3, m4;
        Mixer_GetOutputs(&m1, &m2, &m3, &m4);
        printf(">> M1=%.1f  M2=%.1f  M3=%.1f  M4=%.1f  (Gas %.0f%%)\r\n",
               m1, m2, m3, m4, setpoint.throttle);
    }

    /* Die frueheren Motortests 'm1 20' und nackte Zahlen sind entfallen:
     * Solange gearmt ist, schreibt der Mixer jede Millisekunde alle vier
     * Motoren neu, ein Einzelwert hielt nicht einmal eine Millisekunde. */
    else
    {
        printf(">> Unbekannt: '%s'\r\n", line);
        printf(">> arm | disarm | status | loop | pid | mix | filt | bat | rc |\r\n");
        printf(">> angle | rate | stream on/off | kipp | t <gas> |\r\n");
        printf(">> rrp/arp <wert> | glpf <hz> | alpf <hz> | tau <sek> | batcal <volt> |\r\n");
        printf(">> curzero | curcal <ampere> | batbypass [off]\r\n");
    }

    line_len = 0;
    line_ready = 0;
}

void HAL_UART_RxCpltCallback(UART_HandleTypeDef *huart)
{
    if (huart->Instance == USART2)
        Command_RxByte();
    else if (huart->Instance == USART1)
        CRSF_RxByte();
}

void HAL_UART_ErrorCallback(UART_HandleTypeDef *huart)
{
    if (huart->Instance == USART2)
        Command_RxError();
    else if (huart->Instance == USART1)
        CRSF_RxError();
}
