sooft1k/Drohne/Sensors/mpu6050.h

#ifndef MPU6050_H
#define MPU6050_H

#include "stm32f4xx_hal.h"
#include <stdint.h>

#define MPU6050_ADDR (0x68 << 1)
#define MPU6050_WHO_AM_I 0x75
#define MPU6050_PWR_MGMT_1 0x6B
#define MPU6050_SMPLRT_DIV 0x19
#define MPU6050_CONFIG 0x1A
#define MPU6050_GYRO_CONFIG 0x1B
#define MPU6050_ACCEL_CONFIG 0x1C
#define MPU6050_ACCEL_XOUT_H 0x3B
#define MPU6050_GYRO_XOUT_H 0x43

/* Startwerte der Filter */
#define GYRO_LPF_DEFAULT_HZ 90.0f  /* Software-Tiefpass auf die Drehraten */
#define ACCEL_LPF_DEFAULT_HZ 20.0f /* Software-Tiefpass auf die Beschleunigung */
#define COMP_TAU_DEFAULT_S 0.50f   /* Zeitkonstante des Komplementaerfilters */

/* ===== Einbaulage des Sensors =====
 * Der Chip liegt mit der Bauteilseite nach OBEN. Eingestellt wird, wohin
 * der X-Pfeil auf dem Sensor-Board zeigt (Blick von oben, Nase = vorne).
 * Daraus rechnet MPU6050_Convert die Chip-Achsen in die Koerperachsen um
 * (X vorne, Y rechts, Z unten - Konvention siehe mixer.c).
 *
 * Pruefen mit dem Kipptest aus dem README: Stimmt ein Vorzeichen nicht,
 * ist hier die falsche Lage eingestellt. */
#define IMU_X_VORNE 0
#define IMU_X_RECHTS 1
#define IMU_X_HINTEN 2
#define IMU_X_LINKS 3

#define IMU_ALIGN IMU_X_VORNE

typedef struct
{
    /* Rohwerte in Chip-Achsen */
    int16_t accel_x;
    int16_t accel_y;
    int16_t accel_z;
    int16_t gyro_x;
    int16_t gyro_y;
    int16_t gyro_z;
    int16_t temp_raw;

    /* Umgerechnet und gefiltert, in KOERPERACHSEN - das benutzt die Regelung.
     * gyro_x = Rolldrehrate, gyro_y = Nickdrehrate, gyro_z = Gierdrehrate.
     * Im Stand liegt accel_z bei -1 g (Z zeigt nach unten). */
    float accel_x_g;
    float accel_y_g;
    float accel_z_g;
    float gyro_x_dps;
    float gyro_y_dps;
    float gyro_z_dps;

    /* Ungefiltert, Koerperachsen - nur zum Vergleichen im Stream */
    float gyro_x_raw_dps;
    float gyro_y_raw_dps;
    float gyro_z_raw_dps;

    /* Gyro-Offsets in Chip-Achsen (aus Kalibrierung) */
    float gyro_x_offset;
    float gyro_y_offset;
    float gyro_z_offset;

    /* Gefilterte Lagewinkel in Grad, Vorzeichen siehe mixer.c */
    float roll;
    float pitch;
    float yaw;
} MPU6050_Data_t;

HAL_StatusTypeDef MPU6050_Init(I2C_HandleTypeDef *hi2c);
HAL_StatusTypeDef MPU6050_InitTimeout(I2C_HandleTypeDef *hi2c, uint32_t timeout);
HAL_StatusTypeDef MPU6050_WhoAmI(I2C_HandleTypeDef *hi2c, uint8_t *id);
HAL_StatusTypeDef MPU6050_ReadAll(I2C_HandleTypeDef *hi2c, MPU6050_Data_t *data);

/* Gyro-Kalibrierung. Gilt als bewegt, wenn eine Achse staerker streut */
#define MPU6050_CAL_MAX_STD_DPS 1.0f
typedef enum
{
    MPU6050_CAL_OK = 0,
    MPU6050_CAL_BEWEGT,     /* Drohne wurde bewegt */
    MPU6050_CAL_LESEFEHLER  /* mehr als 10 % der Messungen nicht lesbar */
} MPU6050_CalResult_t;
MPU6050_CalResult_t MPU6050_Calibrate(I2C_HandleTypeDef *hi2c, MPU6050_Data_t *data, uint16_t samples);

/* Roll/Pitch aus dem Accel setzen (braucht umgerechnete Werte) */
void MPU6050_InitAngles(MPU6050_Data_t *data);

/* ===== Lesen im Regelbetrieb, per Interrupt =====
 * MPU6050_ReadAll oben blockiert und ist nur fuer Start und Kalibrierung. */

/* Fehler in Folge, ab denen der Sensor als ausgefallen gilt (1 pro ms) */
#define MPU6050_FAIL_LIMIT 20
/* Gute Messungen in Folge, ab denen er wieder als gesund gilt (1 pro ms) */
#define MPU6050_GOOD_TO_RECOVER 500
/* Identische Messungen in Folge, ab denen die Werte als eingefroren gelten
 * (der Sensor gilt dann sofort als ausgefallen) */
#define MPU6050_FROZEN_LIMIT 100

/* Startet einen Lesevorgang per Interrupt. Aus dem TIM2-Interrupt aufrufen.
 * Blockiert nie: ist der Bus belegt, wird das als Fehler gemeldet. */
HAL_StatusTypeDef MPU6050_StartRead(I2C_HandleTypeDef *hi2c);

/* Holt das Ergebnis ab: 1 = neue Rohwerte in data, 0 = Transfer laeuft
 * noch, -1 = Fehler (oder nichts gestartet, oder Werte eingefroren). */
int MPU6050_ReadPoll(MPU6050_Data_t *data);

uint8_t MPU6050_ReadBusy(void);           /* 1 = Transfer laeuft */
void MPU6050_BlockReads(uint8_t block);   /* 1 = keine neuen Transfers (Recovery) */

/* Ergebnis jedes Regelzyklus melden, fuehrt den Fehlerzaehler */
void MPU6050_ReportResult(uint8_t ok);
uint8_t MPU6050_Failed(void);      /* 1 = MPU6050_FAIL_LIMIT Fehler in Folge */
uint8_t MPU6050_Healthy(void);     /* 1 = nicht ausgefallen und seit 0,5 s stabil */
uint16_t MPU6050_FailRun(void);    /* aktuelle Fehler in Folge */
uint32_t MPU6050_ErrorCount(void); /* Fehler seit dem Start */

/* Braucht jetzt dt, weil die Filter darauf rechnen */
void MPU6050_Convert(MPU6050_Data_t *data, float dt);
void MPU6050_UpdateAngles(MPU6050_Data_t *data, float dt);

/* Filter zur Laufzeit einstellen - 0 schaltet den jeweiligen Filter ab */
void MPU6050_SetGyroLPF(float hz);
void MPU6050_SetAccelLPF(float hz);
void MPU6050_SetCompTau(float seconds);
float MPU6050_GetGyroLPF(void);
float MPU6050_GetAccelLPF(void);
float MPU6050_GetCompTau(void);

#endif
