sooft1k/Drohne/(commit log)

2026-07-26 Motor 1-4 Code
2026-09-19 PID Mixer
2026-10-13 FC-Hardware: KiCad-Projekt (Schaltplan, Platzierung, Vorverdrahtung) - Zwischenstand
    Generatoren in hardware/fc/scripts erzeugen Schaltplan und Platine aus
    design.py. Routing folgt.
    Claude-Session: https://claude.ai/code/session_01JZYB7PZbCVuDQ6ovPGKpbm
2026-10-13 FC-Hardware: vollständiges Routing, DRC sauber, JLCPCB-Fertigungsdaten
    - Routing über alle vier Lagen: Handverdrahtung der kritischen Stellen
    (Abblockung, Schaltregler, USB-C/VBUS/CC, USB D+/D-, SPI-Bündel zum Gyro),
    Fanout in die Versorgungsflächen, Freerouting für die übrigen Signale,
    eigener Nachrouter (A*, mit Rip-up) für Restverbindungen
    - Lage 2 durchgehend GND, Lage 3 VBAT/+5V/+3V3, außen GND-Restflächen
    - DRC (KiCad 7.0.11): 0 Verstöße, 0 offene Verbindungen, 0 Footprint-Fehler;
    Platine <-> Schaltplan-Netzliste: 310 Pads, 0 Abweichungen
    - GPIO4 auf PC5 verlegt (PA1 nicht entflechtbar), USB-C-Footprint mit an der
    Platinenkante gekürztem Bestückungsdruck
    - Fertig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
2026-10-13 FC: JLCPCB-Bestückung vorbereitet (LCSC-Nummern, CPL-Drehlagen, ERC)
    - scripts/lcsc.py: LCSC-Nummer für alle 71 Bauteile der Oberseite, Typ
    Basic/Preferred/Extended nach der JLCPCB-Liste vom 13.10.2026, Bestand mit
    Datum und Quelle; 11 Extended-Teile, 4 Preferred
    - Stückliste getrennt: jlcpcb_bom.csv / jlcpcb_cpl.csv (Oberseite, maschinell),
    handbestueckung_unten.csv (Steckverbinder J2-J11)
    - CPL mit Drehkorrektur (Tabelle JLCKicadTools) und Prüfliste mit Lage von
    Pin 1 bzw. Kathode/Pluspol je Bauteil; LGA-14 und HSOP-8 ohne Tabellenwert
    - Basic statt Extended: 5-V-Rückführung 33k/8,2k (5,02 V) statt 100k/24,9k;
    R16 470 Ohm für die grüne InGaN-LED; Quarz CL 12 pF passend zu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
2026-10-13 FC: 3D-Renderings und Modellpfad des LMR33630
    - docs/fc_3d_*.png: Raytracing-Ansichten (oben, unten, schräg) mit KiCad 9
    - 3D-Modell des HSOP-8 (U4) auf den Dateinamen ab KiCad 8 umgestellt
    (HTSOP-8-1EP_3.9x4.9mm_P1.27mm), in Projektbibliothek und Platine;
    nur der Modellpfad, Kupfer unverändert, DRC 0/0
    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
2026-10-13 FC: JST-SH-Buchsen unten, beidseitige JLCPCB-Bestückung
    - Steckverbinder J3–J11 statt SMD-Stiftleisten jetzt JST-SH 1,0 mm
    (seitlich steckbar) wie J2; Randbuchsen an Nord-, West-, Ost- und
    Südkante, SWD und Piepser innen
    - Versorgungspins der Buchsen per Handverdrahtung an die Flächen,
    M3/M4 fest vorverlegt; komplett neu geroutet (DRC 0/0, ERC 0 Fehler,
    Platine = Schaltplan 319 Pads)
    - Fertigungsdaten für Standard-PCBA beider Seiten: BOM/CPL mit
    Unterseite (Megastar ZX-SH1.0, LCSC), Drehlagen aus Pad-Vergleich
    mit den JLC-Footprints (SOT-23 jetzt +180°, HSOP-8 +270° angenommen)
    - README: Buchsenbelegung, Bestellablauf, Edge Rails, Prüfpunkte
    - 3D-Ansichten und Lagenbilde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
2026-10-13 FC: ELRS/GPS/I²C oben, Prüfbefunde behoben, 39 Teilenummern
    - ELRS, I²C und GPS als JST-SH-Buchsen oben an der Westkante (im
    verschraubten Stack steckbar); LEDs östlich des Gyros, Fiducials
    versetzt; SWD und Piepser unten an die frei gewordenen Randplätze
    - Prüfbefunde: C22 mit Masse direkt an PGND des LMR33630, Akku-Pfad
    0,8 mm mit je zwei Vias, VBAT-Streifen auf Lage 3 >= 2,5 mm, C7 direkt
    an VDDA, D1 weiter von der Kante, JP2 weg von der Massebohrung, UART-
    Buchse weg von den Wärmevias, Bestückungsdruck >= 1,0 mm / 0,16 mm
    - Teilenummern 43 -> 39 (100 nF alle 50 V, 10 µF/25 V, 1 k, 5,1 k),
    Akkuteiler 100k/10k, Piepser-FET AO3400A
    - route: Stichleitungen über ein Pad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
2026-10-13 FC: CPL-Drehungen nach JLC-Footprints korrigiert (JST-SH, USB-C, Elko)
    - JST-SH (ZX-SH1.0, C7430446) und USB-C (C165948): Korrektur 0° statt
    180°; die EasyEDA-Footprints der bestellten Teile liegen wie KiCad.
    Mit 180° hätte JLC die Buchsen verkehrt herum gesetzt.
    - Elko C21: 0° angenommen (Pluspol links), als Prüfpunkt markiert
    - Simulation EasyEDA-Footprint mit CPL-Drehung auf KiCad-Pads: alle
    vergleichbaren Teile passen ohne Zusatzdrehung
    - LEDs gelb/grün sind seit 03/2025 Extended (nicht mehr Preferred)
    - README: Edge-Rails-Hinweis, DShot-DMA-Belegung, Prüfpunkte
    Claude-Session: https://claude.ai/code/session_01JZYB7PZ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
2026-10-14 FC: J2 auf B-Cube 4in1, getrennte 4,5-V-Schiene, C21 47 uF, Pfeil VORNE
    - J2 nach Messung am B-Cube 4in1: 1 GND, 2 VBAT, 3-6 M1-M4, 7 Strom,
    8 NC (unbeschaltet), fuer 1:1-Kabel. JP2 und ESC_5V entfernt.
    Motorpins am Prozessor unveraendert (wie Sensors/motor.c).
    - +4V5 wie bei Matek: VBUS -> D2 und +5V -> D7 (SS14, Unterseite) auf
    AMS1117, ELRS und GPS. VTX, Kamera und Piepser laufen an USB nicht mit.
    - C21 470 uF -> 47 uF/35 V 6,3x5,4 (C48970990), Einschaltstrom.
    - Nordkante = vorn: Pfeile und VORNE im Bestueckungsdruck.
    - README: Firmware-Hinweise (NOVBUSSENS, DMA-Konflikt DShot/GPS-TX/
    Debug-RX, Gyro CW270 inkl. Betaflight ab 2025.12, ADC-Pins),
    J2-Lage von oben, Pruefanleitung v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
2026-10-14 FC: Pruefbefunde Layout/Fertigung/README behoben
    - +4V5 Diodenknoten -> AMS1117 unter der USB-C-Buchse nur noch auf B.Cu
    (vorher F.Cu direkt unter dem Blechgehaeuse), als Handverdrahtung;
    TP2 1 mm nach Osten.
    - D1 um 180 Grad gedreht: Q1_G ohne Vias, der VBAT-Suedstreifen auf
    Lage 3 ist nicht mehr auf 0,7 mm eingeschnuert (jetzt 2,2 mm).
    - GND-Anschluss J2 Pin 1 auf 0,5 mm, doppelte/Null-Bahnstuecke entfernt.
    - BOM-Kommentar = Beschreibung des bestellten Teils statt Wert der
    ersten Referenz.
    - README: gemessene VBAT-Breiten, Lage der Testpunkte, mkdir build,
    3D-Render-Befehl, Elko-Drehlage, LED-Ersatz, SPI-Laengen, Kennzahlen.
    - DRC 0 (KiCad 7 und 9), 319 Pads ohne Abweichung; Fert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
2026-10-14 FC README: J2-Zeichnung beider Stecker, Pflichtpruefung vor dem ersten Akku
    - ASCII-Zeichnung FC-J2 und ESC-Buchse in Einbaulage (von oben, Oeffnung
    zum Betrachter) mit Signal und Kontaktnummer je Pin, 1:1-Zuordnung.
    - Pruefung vor dem ersten Akku als eigener Abschnitt: Kabel gesteckt,
    kein Akku, vor dem Verschrauben; bei Abweichung nicht einstecken,
    sondern melden.
    - ESC-Buchse auf der Oberseite vom Nutzer bestaetigt (Annahme entfernt).
    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
2026-10-15 Submodul-Adresse fuer Drivers/STM32F4 nachgetragen
    Drivers/STM32F4 ist als Submodul (STM32CubeF4 @194d6ca) eingetragen,
    aber .gitmodules fehlte. Jeder Checkout mit Submodulen brach deshalb mit
    "No url found for submodule path 'Drivers/STM32F4'" ab, auch der
    GitHub-Pages-Build. Mit der Adresse holt "git clone --recursive" die
    HAL- und CMSIS-Treiber, die das Makefile erwartet.
    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
2026-10-15 FC README: Bestellformular JLCPCB (Stand Okt. 2026), Innenkupfer 0,5 oz
    - Lagenaufbau korrigiert: JLC04161H-7628 hat 0,5 oz innen ("H"); fuer
    1 oz innen hiesse der Aufbau JLC041611-7628 (rund 17 USD Aufpreis).
    0,5 oz als Abweichung mit Begruendung (VBAT-Streifen auf Lage 3,
    IPC-2221) eingetragen.
    - Bestellablauf: alle Felder fuer Platine und Bestueckung als Tabellen,
    Bemerkung aufgeteilt in PCB Remark (USB-C) und Assembly remark
    (C21, D7), Confirm Production file / Parts Placement mit
    "Do not confirm automatically", Raender abtrennen lassen.
    - Gebuehren Standard PCBA nach Preisliste Stand 09/2026.
    Claude-Session: https://cl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
2026-10-15 Hardware-Ordner entfernt (Platine macht ein Kollege)
    Der komplette Ordner hardware/ (KiCad-Projekt der FC-Platine, Skripte,
    Fertigungsdaten fuer JLCPCB, Doku und Renderings) wird aus dem Repo
    genommen. Firmware (Core, Sensors, Drivers, Makefile) bleibt unveraendert.
    Der Stand bleibt in der Git-Historie erhalten (Commit 6cf200e).
    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
2026-10-19 Block 1: Vorzeichenkonvention, Leerlauf und Failsafe-Gasrampe
    - Eine Konvention fuer alles (Luftfahrt, X vorne / Y rechts / Z unten):
    Roll + = rechts runter, Pitch + = Nase hoch, Yaw + = Nase nach rechts.
    Beschrieben oben in mixer.c und im neuen README.
    - Sensor: Chip-Achsen werden je nach Einbaulage (IMU_ALIGN in mpu6050.h)
    auf Koerperachsen umgerechnet, Lagewinkel aus dem Accel nach derselben
    Konvention. Behebt die mitgekoppelte Nickachse.
    - Mixer: Yaw-Vorzeichen korrigiert (CCW-Motoren drehen den Rahmen nach
    rechts), Pitch-Knueppel vor = Nase runter.
    - Gearmt laufen die Motoren mindestens im Leerlauf (15 %), Gas 0..100 %
    linear auf Leerlauf..Vollgas. Kein Abschalten bei Gas <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
2026-10-19 Block 1: Korrekturen aus dem Review
    Sicherheitsfehler, die das Review an der ersten Fassung von Block 1
    gefunden hat:
    - Airmode erst, wenn das Gas seit dem Armen einmal 25 % erreicht hat.
    Vorher bleibt es bei Gas 0 beim reinen Leerlauf - eine schief stehende
    Drohne kippt am Boden nicht mehr um. Airmode wird bei jedem Armen
    zurueckgesetzt.
    - Terminal-disarm sperrt das Wiederarmen ueber den Schalter, bis er einmal
    unten war. Vorher armte der oben stehende Schalter 1 ms spaeter wieder.
    - Failsafe: Der Arm-Schalter schaltet auch waehrend der Rampe sofort ab.
    Rampe nach Uhrzeit statt nach Zahl der Regelzyklen. War das Gas schon
    1 s unten (gelandet), sofort disarmen statt Rampe.
    - Kom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
2026-10-19 Block 2: Absicherung
    - Fault-Handler, Error_Handler und assert_failed setzen zuerst alle vier
    Motorpulse auf Stopp (Motor_EmergencyStop, direkt in die TIM3-Register,
    ohne Vorladung, damit nichts verlaengert wird).
    - Watchdog (IWDG, ca. 100 ms, je nach LSI 68..188 ms), Start nach der
    Gyro-Kalibrierung, Meldung beim Neustart durch den Watchdog.
    - HAL-Asserts wirklich aus (USE_FULL_ASSERT war mit #ifdef trotz 0 aktiv).
    - MPU6050 wird per Interrupt gelesen: der TIM2-Takt startet den Transfer,
    die Hauptschleife wartet hoechstens bis 0,8 ms nach dem Takt. Das BUSY-
    Flag wird selbst geprueft, die 25-ms-Warteschleife der HAL entfaellt.
    - Sensorausfall: 20 Fehler in Folge oder 100 eingefror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
2026-10-19 Block 3: Regelung
    - PID-Reset ohne D-Ausschlag: der erste Messwert nach dem Reset gilt als
    Vorwert der Ableitung.
    - dt wird mit dem Taktzaehler (DWT) gemessen statt fest 1 ms
    angenommen, begrenzt auf 0,2..20 ms.
    - D-Tiefpass aus Grenzfrequenz und dt berechnet (25 Hz), statt festem
    Faktor, der von der Schleifenfrequenz abhing.
    - I-Anteil direkt begrenzt (unabhaengig von Ki) und Anti-Windup: kein
    weiteres Aufintegrieren, solange der Ausgang am Limit steht oder der
    Mixer die Korrekturen stauchen muss.
    - Moduswechsel setzt nur noch den Winkelregler zurueck.
    - Gyro auf +-2000 Grad/s.
    - Gearmt keine Terminal-Ausgaben; nur disarm/stop und t wirken.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
2026-10-19 Block 4: Akku, Strommessung und Telemetrie
    - Zellenerkennung: Filter startet mit dem ersten Messwert statt bei 0 V.
    Vorher wurde bei rund 90 % der echten Spannung erkannt (z.B. 4S mit
    3,5 V/Zelle als 3S, Warnung kam dann nie). BAT_CELLS_DEFAULT wirkt jetzt.
    - Warnung und Gasbegrenzung: unter 3,5 V/Zelle hoechstens 80 % Gas, unter
    3,3 V/Zelle 60 %. Gearmt erst nach 2 s unter der Schwelle (Spannungs-
    einbrueche bei Vollgas loesen nichts aus), Grenze sinkt mit 20 %/s.
    LED blinkt schneller.
    - Strommessung auf PA4 (ADC2), Nullpunkt automatisch beim Anstecken,
    mAh-Zaehler, Kalibrierung mit 'curzero' und 'curcal <A>'.
    - Akku-Telemetrie an die Funke (CRSF 0x08): Spannung, Strom, mAh, Res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
2026-10-19 Block 5: Arm auf AUX1, Lage aus Accel, Kalibrierung, .gitignore
    - Arm-Schalter auf Kanal 5 (AUX1): ELRS sendet ihn mit jedem Paket,
    die uebrigen Schalter nur reihum.
    - Lagewinkel starten nach der Kalibrierung mit dem Accel-Wert statt 0.
    - Gyro-Kalibrierung teilt durch die erfolgreich gelesenen Werte und
    prueft, ob die Drohne still lag (Streuung <= 1 Grad/s). Bis zu 5
    Versuche, sonst bleibt Arming gesperrt.
    - .gitignore angelegt, build/ und venv/ aus dem Repo genommen.
    Claude-Session: https://claude.ai/code/session_01QFZSEpSnoKWMeEytza4QQp
2026-10-19 Submodul Drivers/STM32F4 zurueck auf 194d6ca
    6dab418 gibt es im offiziellen STM32CubeF4-Repo nicht, ein frischer Klon
    scheiterte bei 'git submodule update --init'. 194d6ca ist der Stand, gegen
    den die Firmware gebaut und getestet ist.
    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
2026-10-19 Bloecke 3-5: Korrekturen aus dem Review
    - Lagewinkel integrieren die Zeit seit der letzten gueltigen Messung
    - I-Anteil erst mit aktivem Airmode, Nulldurchgang beim Anti-Windup
    - Strom-Nullabgleich 3 s nach dem Anstecken, mit Ruhepruefung; ohne
    Nullpunkt kein Strom und keine mAh
    - Zellenerkennung 3,3..4,38 V (HV-LiPo voll, leerer 4S nicht als 3S)
    - batcal lehnt mehr als 20 % Abweichung ab, curcal auch gearmt
    - Gyro-Kalibrierung verwirft Offsets ueber 40 Grad/s
    - LED leuchtet dauernd ohne Sensor, Hilfetext mit Kanal 5
    - README: Airmode/I-Anteil, Strom-Kalibrierung, Umstellung auf Kanal 5
    Claude-Session: https://claude.ai/code/session_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
2026-10-19 README: Verdrahtung fuer den Aufbau mit MPU6050
    Spannungsteiler an PC0, Schutz fuer PA4, Herkunft des Stromsignals am
    ESC, Pull-downs an den Motorsignalen, Bauteilliste.
    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
2026-10-19 Terminal-Arm: Abschaltung ohne Lebenszeichen, ESC-Einstellung im README
    - Ueber das Terminal gearmt: kommt laenger als 1 s kein fehlerfreies
    Zeichen ueber USART2, wird sofort disarmt. Ein Enter alle 0,5 s reicht.
    Zeichen mit Rahmen-/Rausch-/Ueberlauffehler zaehlen nicht.
    - Gilt nur fuer den Terminal-Arm: arming.c zaehlt die Arm-Vorgaenge,
    ein spaeterer Arm ueber den Schalter ist davon nicht betroffen.
    - README: BLHeli_S-Gasbereich (Min 1040, Max 2000, Programming by TX aus),
    Zugang zu den ESCs ohne Passthrough, Keepalive mit Beispielskript.
    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
2026-10-19 Motorsignal auf die Werkseinstellung des BLHeli_S skaliert
    - Gearmt 0..100 % = 143,5..229 us (PPM 1148..1832 us / 8) statt 125..250 us.
    Disarmed, beim Start und im Notaus weiter 125 us (MOTOR_US_STOP).
    - Grenzen als MOTOR_US_STOP/MIN/MAX in motor.h, Ticks gerundet.
    - Leerlauf 5 % (147,8 us) statt 15 %: die alte Anlaufschwelle
    (143,75 us) lag genau am ESC-Minimum.
    - README: ESC-Umprogrammierung nur noch optional, Tabelle der Pulsbreiten.
    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
2026-10-20 Arm-Schalter zurueck auf Kanal 8 (AUX4)
    Die RadioMaster T8L kann Kanal 5 keinem Schalter zuordnen. Modus bleibt
    auf Kanal 7. Starttext und rc-Ausgabe nennen die Kanaele.
    README: Kanalbelegung und neuer Abschnitt "Arm-Schalter und ELRS" mit
    der Verzoegerung durch das Reihum-Senden von AUX2..AUX8 (bei 250 Hz
    hoechstens 28/32 ms, Hybrid/Wide).
    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
2026-10-25 Pruefstand-Befehl batbypass: Akkupruefung beim Armen ueberspringen
    Ohne Widerstaende fuer den Akkuteiler lehnt die Firmware das Armen mit
    "keine Akkuspannung" ab. 'batbypass' im Terminal schaltet die
    Akkupruefung und die Gasbegrenzung bei niedrigem Akku ab:
    - nur ueber das Terminal (disarmed), nicht ueber die Funke
    - nur im RAM, nach jedem Reset wieder aus; 'batbypass off' schaltet ab
    - Warnung "AKKUPRUEFUNG AUS - NUR OHNE PROPELLER" beim Einschalten und
    nach jedem Armen (gearmt per HAL_UART_Transmit_IT, blockiert nicht)
    - Sensor, Neigung, Gas und Arm-Schalter werden weiter geprueft
    Dazu Host-Tests unter tests/ (make -C tests).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
2026-11-06 README an den Code von main angepasst
    Kipptest-Wert, batcal-Grenzen und das Warten auf den MPU6050 korrigiert,
    Status-LED ergaenzt und auf den Branch fc-platine verwiesen.
2026-11-09 Frame: parametrischer 5-Zoll-Frame zum Drucken aus PETG
    frame.py erzeugt Bodenplatte, Deckplatte, Kamerahalterung und GPS-Mast
    als STL und die Baugruppe als STEP. Mit MATERIAL = "carbon" kommen die
    Platten zusaetzlich als DXF zum Fraesen, die Bohrungen bleiben gleich.
2026-11-09 Frame entfernt
